UMDBPP/HELIOS/README.md

# HELIOS
Arduino code and CAD design files for the UMDBPP Helium Valve Payload
