UMDBPP/HELIOS/PCBShield/BOM.xlsx

Part | New Cost | Actual Cost | Quantity | Total | New Cost | Link | Resources
XBEE Module | $37.95 | $0.00 | 1 | $0.00 | $37.95 | https://www.adafruit.com/product/964
SD Card Breakout | $4.95 | $4.95 | 1 | $4.95 | $4.95 | https://www.digikey.com/product-detail/en/sparkfun-electronics/DEV-13743/1568-1356-ND/5881845
L293DNE | $2.95 | $0.00 | 1 | $0.00 | $2.95 | https://www.adafruit.com/product/807
I2C Multiplexer | $6.95 | $0.00 | 1 | $0.00 | $6.95 | https://www.adafruit.com/product/2717
GPS Breakout | $39.95 | $0.00 | 1 | $0.00 | $39.95 | https://www.adafruit.com/product/746
Logic Shifter | $3.50 | $3.50 | 1 | $3.50 | $3.50 | https://www.adafruit.com/product/1875
3.3V Regulator | $1.25 | $1.25 | 1 | $1.25 | $1.25 | https://www.adafruit.com/product/2165
Comparator | $3.39 | $3.39 | 1 | $3.39 | $3.39 | https://www.digikey.com/product-detail/en/linear-technology/LTC1042CN8-PBF/LTC1042CN8-PBF-ND/888973
50k Potentiometer | $2.08 | $2.08 | 1 | $2.08 | $2.08 | https://www.digikey.com/product-detail/en/bourns-inc/PV37W503C01B00/490-2984-ND/666611
10k Resistor | $0.10 | $0.00 | 2 | $0.00 | $0.20 | https://www.digikey.com/product-detail/en/stackpole-electronics-inc/CF14JT10K0/CF14JT10K0CT-ND/1830374
1k Resistor | $0.10 | $0.00 | 1 | $0.00 | $0.10 | https://www.digikey.com/product-detail/en/stackpole-electronics-inc/CF14JT1K00/CF14JT1K00CT-ND/1830350
4.7k Resistor | $0.10 | $0.00 | 16 | $0.00 | $1.60 | https://www.digikey.com/product-detail/en/stackpole-electronics-inc/CF14JT4K70/CF14JT4K70CT-ND/1830366
470 Resistor | $0.10 | $0.00 | 6 |  | $0.60 | https://www.digikey.com/product-detail/en/stackpole-electronics-inc/CF14JT470R/CF14JT470RCT-ND/1830342
N Channel MOSFET | $3.03 | $0.00 | 1 | $0.00 | $3.03 | https://www.digikey.com/products/en?keywords=FQP85N06 | https://media.digikey.com/pdf/Data%20Sheets/Fairchild%20PDFs/TO220B03_Pkg_Dwg.pdf
P Channel MOSFET | $1.33 | $0.00 | 2 | $0.00 | $2.66 | https://www.digikey.com/products/en?keywords=fqp27p06 | https://media.digikey.com/pdf/Data%20Sheets/Fairchild%20PDFs/TO220B03_Pkg_Dwg.pdf
High Power H Bridge | $5.06 | $5.06 | 1 | $5.06 | $5.06 | https://www.digikey.com/products/en?keywords=sla5074 | http://www.semicon.sanken-ele.co.jp/sk_content/sla5068_ds_en.pdf
2 Pin Headers | $0.49 | $0.49 | 5 | $2.45 | $2.45 | https://www.digikey.com/product-detail/en/sullins-connector-solutions/PPTC031LFBN-RC/S7001-ND/810142
3 Pin Headers | $0.64 | $0.64 | 2 | $1.28 | $1.28 | https://www.digikey.com/product-detail/en/sullins-connector-solutions/PPTC031LFBN-RC/S7001-ND/810143
4 Pin Headers | $0.46 | $0.46 | 10 | $4.63 | $4.63 | https://www.digikey.com/product-detail/en/sullins-connector-solutions/PPTC031LFBN-RC/S7001-ND/810144
6 Pin Headers | $0.78 | $0.78 | 6 | $4.68 | $4.68 | https://www.digikey.com/product-detail/en/sullins-connector-solutions/PPTC031LFBN-RC/S7001-ND/810145
7 Pin Headers | $0.86 | $0.86 | 1 | $0.86 | $0.86 | https://www.digikey.com/product-detail/en/sullins-connector-solutions/PPTC031LFBN-RC/S7001-ND/810146
9 Pin Headers | $0.94 | $0.94 | 1 | $0.94 | $0.94 | https://www.digikey.com/product-detail/en/sullins-connector-solutions/PPTC031LFBN-RC/S7001-ND/810148
12 Pin Headers | $0.98 | $0.98 | 2 | $1.96 | $1.96 | https://www.digikey.com/product-detail/en/sullins-connector-solutions/PPTC121LFBN-RC/S6100-ND/807231
8 Pin Shield Headers | $1.01 | $1.01 | 5 | $5.05 | $5.05 | https://www.digikey.com/product-detail/en/samtec-inc/SSW-108-03-T-S/SAM8866-ND/1790200
10 Pin Shield Headers | $1.61 | $1.61 | 1 | $1.61 | $1.61 | https://www.digikey.com/product-detail/en/samtec-inc/SSQ-110-03-F-S/SAM10010-ND/6678747
36 Pin Shield Headers | $4.19 | $4.19 | 1 | $4.19 | $4.19 | https://www.digikey.com/product-detail/en/samtec-inc/SSQ-118-03-T-D/SAM1204-18-ND/1111842
10 Pin Xbee Headers | $0.95 | $0.95 | 1 | $0.95 | $0.95 | https://www.adafruit.com/product/366
8DIP Socket | $0.19 | $0.19 | 1 | $0.19 | $0.19 | https://www.digikey.com/product-detail/en/on-shore-technology-inc/ED16DT/ED3046-5-ND/4147596
4DIP Socket | $0.16 | $0.16 | 1 | $0.16 | $0.16 | https://www.digikey.com/product-detail/en/on-shore-technology-inc/ED16DT/ED3046-5-ND/4147596
2 Pin Screw Terminals | $0.75 | $0.75 | 9 | $6.75 | $6.75 | https://www.digikey.com/product-detail/en/on-shore-technology-inc/OSTVN02A150/ED10561-ND/1588862 | https://www.sparkfun.com/products/10571
Printed Circuit Board | $20.47 | $20.47 | 3 | $61.41 | $61.40
 |  |  |  | $0.00 | $0.00
 |  |  |  | $0.00 | $0.00
 |  |  |  | $0.00 | $0.00
 |  |  |  | $0.00 | $0.00
 | Total | $117.34 | $213.32
Header Requirements
LEDs | ~~4pin~~ | 2
Actuators | ~~2pin~~ | 5
Actuators | ~~3pin~~ | 2
Multiplexer | ~~12pin~~ | 2
I2C | ~~4pin~~ | 8
Comparator | ~~4DIP~~ | 1
SD Card | ~~7pin~~ | 1
GPS | ~~9pin~~ | 1
H Bridge | ~~8DIP~~ | 1
SPI | ~~6pin~~ | 4
Xbee | ~~10pinx0.5"~~ | 2
Logic Shifter | ~~6pin~~ | 2
Power | ~~2screw~~ | 9
Arduino | ~~10pin_through~~ | 1
Arduino | ~~8pin_through~~ | 5
Arduino | ~~18x2pin_through~~ | 1
Xbee to USB Adapter | 29.95 |  | 1 |  |  | https://www.adafruit.com/product/247 | This is definitely not necessay for this board, but would it be useful for testing in the future?
