UMDBPP/HELIOS/CAD/ActuatorCapPrecise.stl

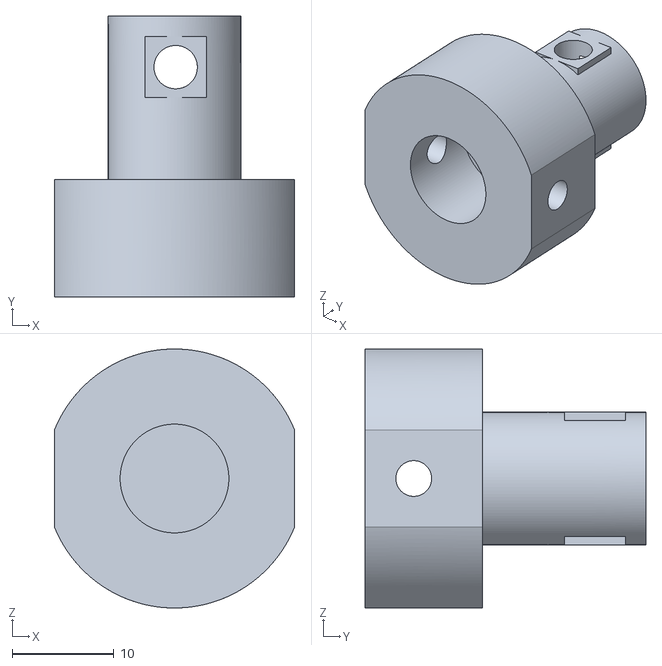
[picture p1: CAD file, 2017-04-02]
CAD/ActuatorCapPrecise.stl
23.5 x 27.5 x 25.4
