UMDBPP/HELIOS/CAD/ActuatorCap.stl

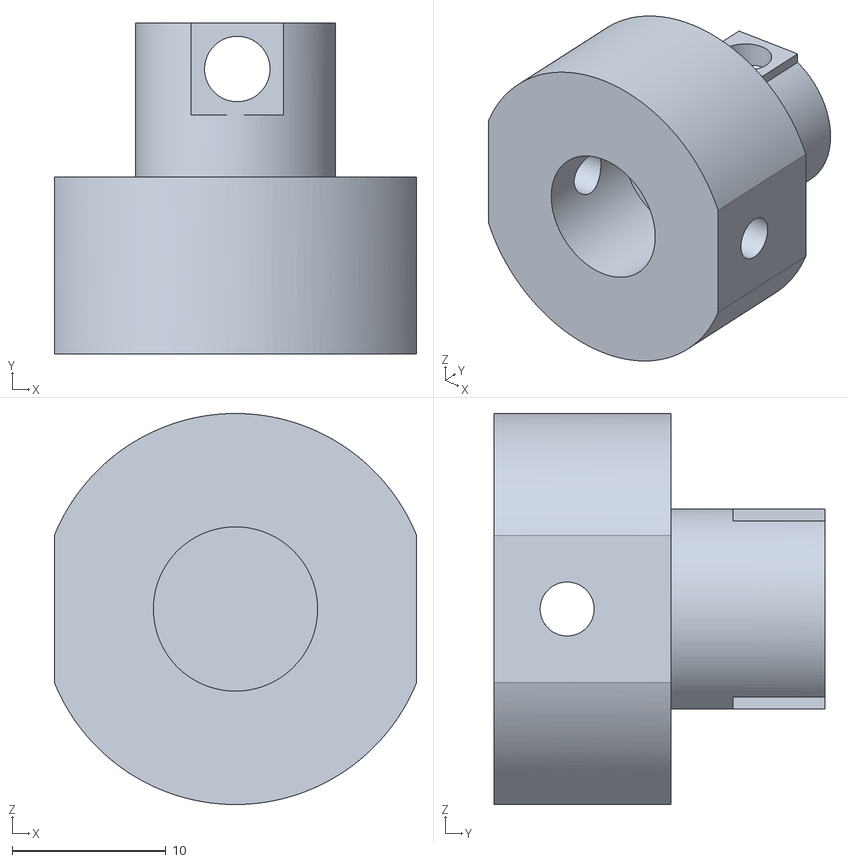
[picture p2: CAD file, 2017-03-31]
CAD/ActuatorCap.stl
23.5 x 21.5 x 25.4
