UMDBPP/HELIOS/CAD/ExtendedHousingLASide1.stl

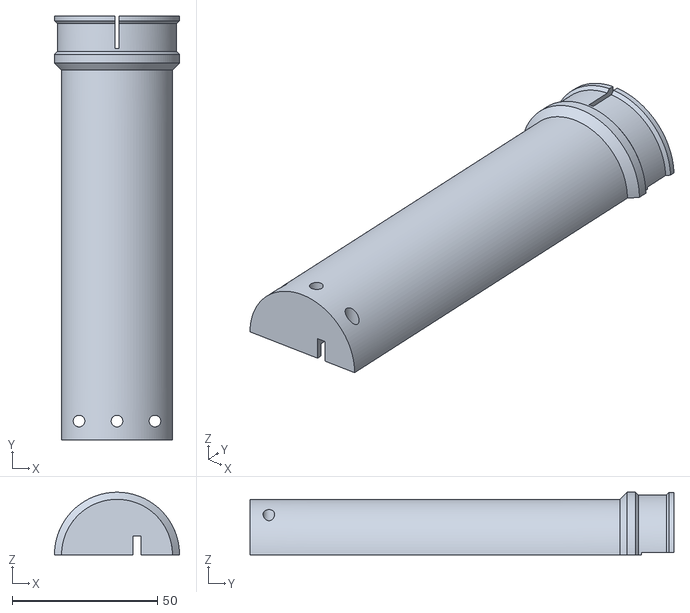
[picture p3: CAD file, 2017-03-28]
CAD/ExtendedHousingLASide1.stl
43.0 x 145.7 x 21.5
