UMDBPP/HELIOS/(list of files, cad)

Other CAD files:
CAD/ExtendedHousingLASide2.stl
CAD/Plug.dwg
CAD/ValveStem.dwg
CAD/Disc.dwg
CAD/ActuatorCap.ipt
CAD/ActuatorCapPrecise.ipt
CAD/ActuatorExtended.ipt
CAD/ActuatorRetracted.ipt
CAD/Disc.ipt
CAD/ExtendedHousingLAMaster.ipt
CAD/ExtendedHousingLASide1.ipt
CAD/ExtendedHousingLASide2.ipt
CAD/EyeBolt.ipt
CAD/Fan.ipt
CAD/FanMount.ipt
CAD/FillPlug.ipt
CAD/FillPort.ipt
CAD/FillPortUpdated.ipt
CAD/Helios.iam
CAD/LargeO-Ring.ipt
CAD/Plug.ipt
CAD/Prototypes/ExtendedHousingSide1wWireSupport.ipt
CAD/Prototypes/ExtendedHousingSide1wWireSupportPrototype.ipt
CAD/Prototypes/ExtendedHousingSide2wWireSupport.ipt
CAD/Prototypes/ExtendedHousingSide2wWireSupportPrototype.ipt
CAD/Prototypes/FullExtendedHousingSide1.ipt
CAD/Prototypes/FullExtendedHousingSide2.ipt
CAD/ReciprocatingO-Ring.ipt
CAD/ValveStem.ipt
