UMDBPP/HELIOS/WiringDiagram/Helios_v3_wire_diagram.png

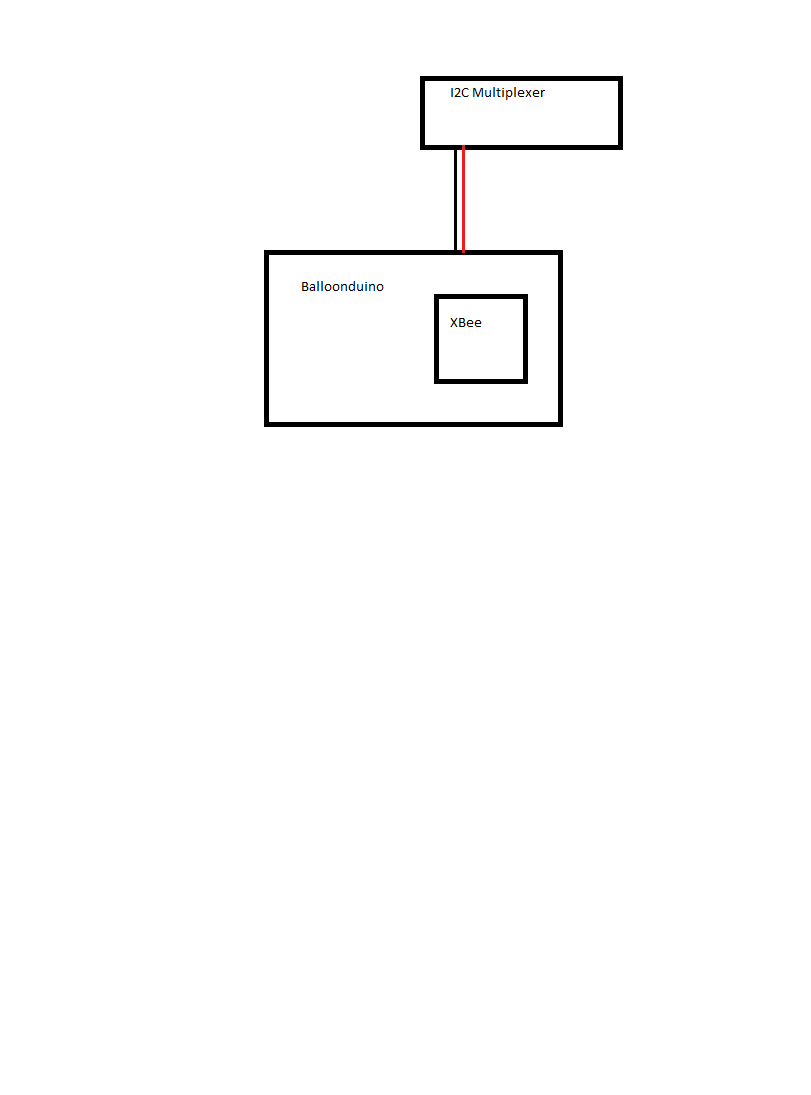
WiringDiagram/Helios_v3_wire_diagram.png
