UMDBPP/HELIOS/CAD/Disc.pdf

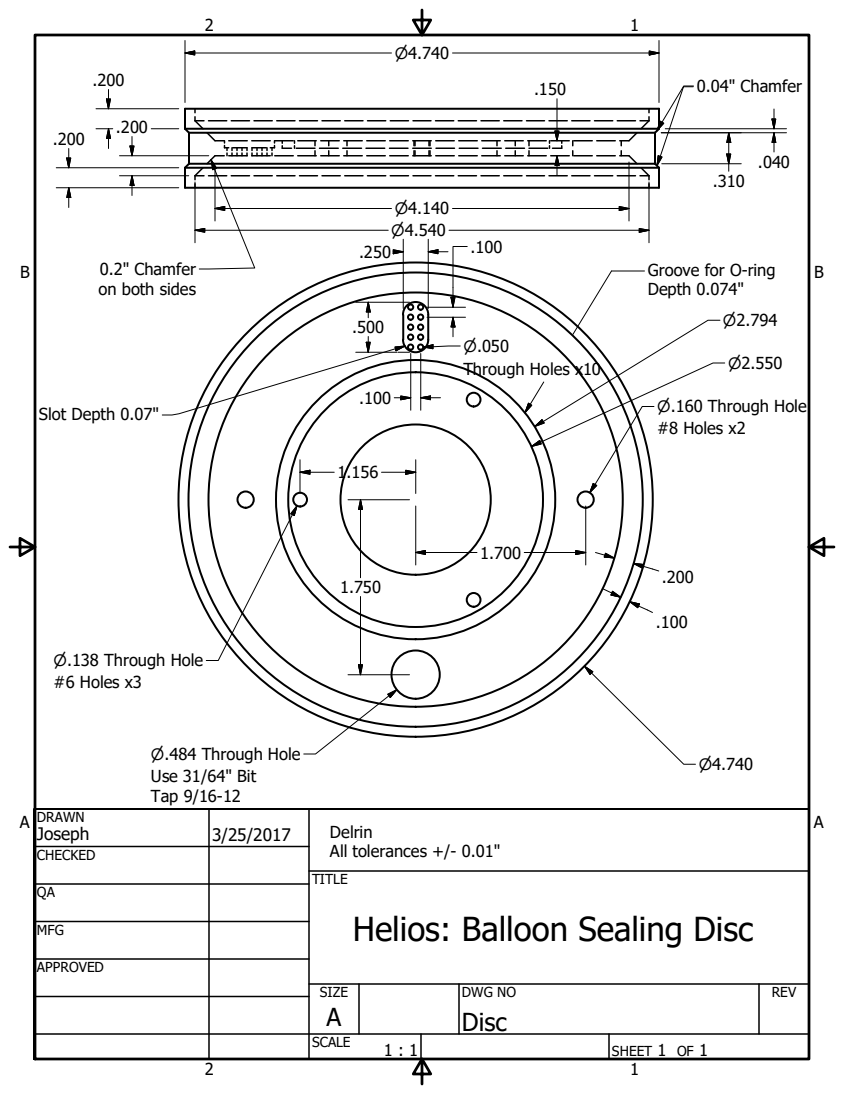
[picture p5: page 1]
SHEET 1 OF 1; DRAWN; CHECKED; MFG; APPROVED; Joseph; DWG NO Disc; SIZE A; SCALE; REV; Delrin All tolerances +/- 0.01"; P.160 Through Hole; #8 Holes x2; P.138 Through Hole; #6 Holes x3; Through Holes x10; P.484 Through Hole; Use 31/64" Bit Tap 9/16-12; 0.04" Chamfer; Slot Depth 0.07"

0.2" Chamfer
on both sides

Groove for O-ring
Depth 0.074"

TITLE
Helios: Balloon Sealing Disc
