UMDBPP/HELIOS/CAD/Plug.pdf

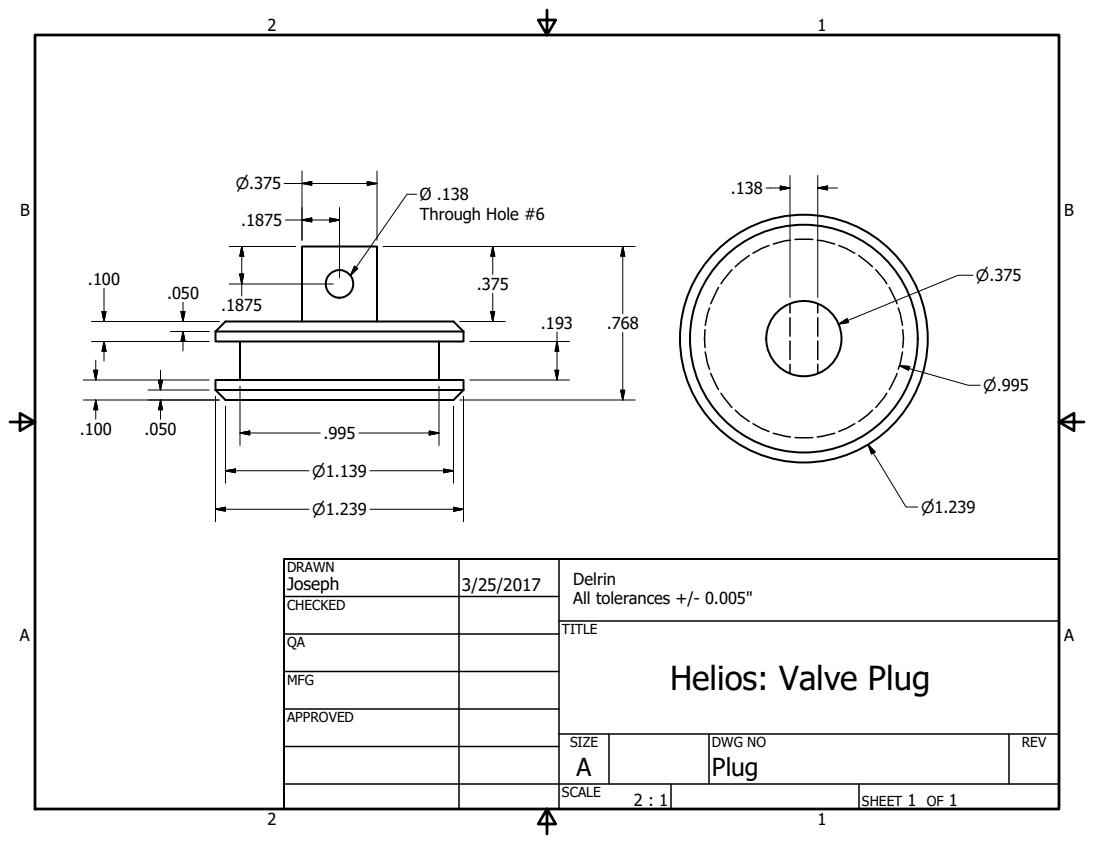
[picture p6: page 1]
SHEET 1 OF 1; DRAWN; CHECKED; MFG; APPROVED; Joseph; DWG NO Plug; TITLE; SIZE A; SCALE; REV; Delrin All tolerances +/- 0.005"; Ø .138 Through Hole #6

Helios: Valve Plug
