UMDBPP/HELIOS/CAD/ValveStem.pdf

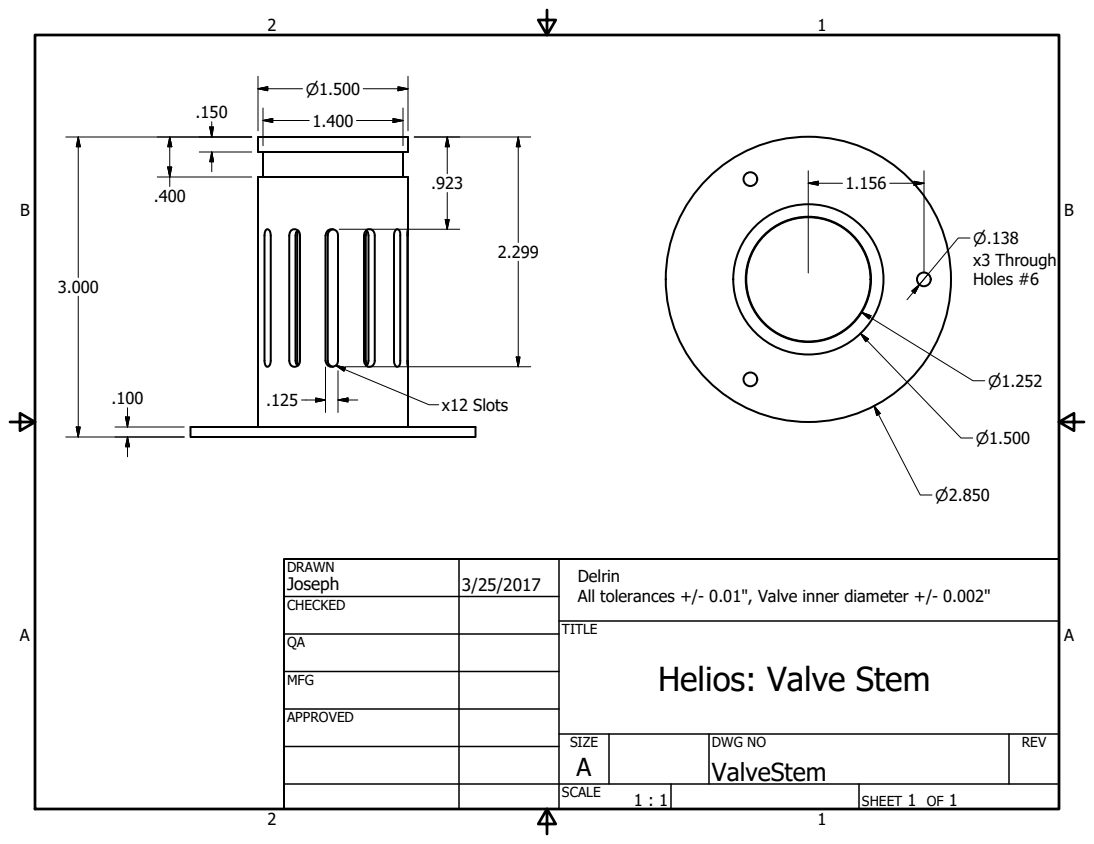
[picture p7: page 1]
SHEET 1 OF 1; DRAWN; CHECKED; MFG; APPROVED; Joseph; DWG NO ValveStem; TITLE; SIZE A; SCALE; REV; x3 Through Holes #6; x12 Slots

Delrin
All tolerances +/- 0.01", Valve inner diameter +/- 0.002"

Helios: Valve Stem
