UMDBPP/HELIOS/PCBShield/shield.brd

## EAGLE design PCBShield/shield.brd (2017-09-26)

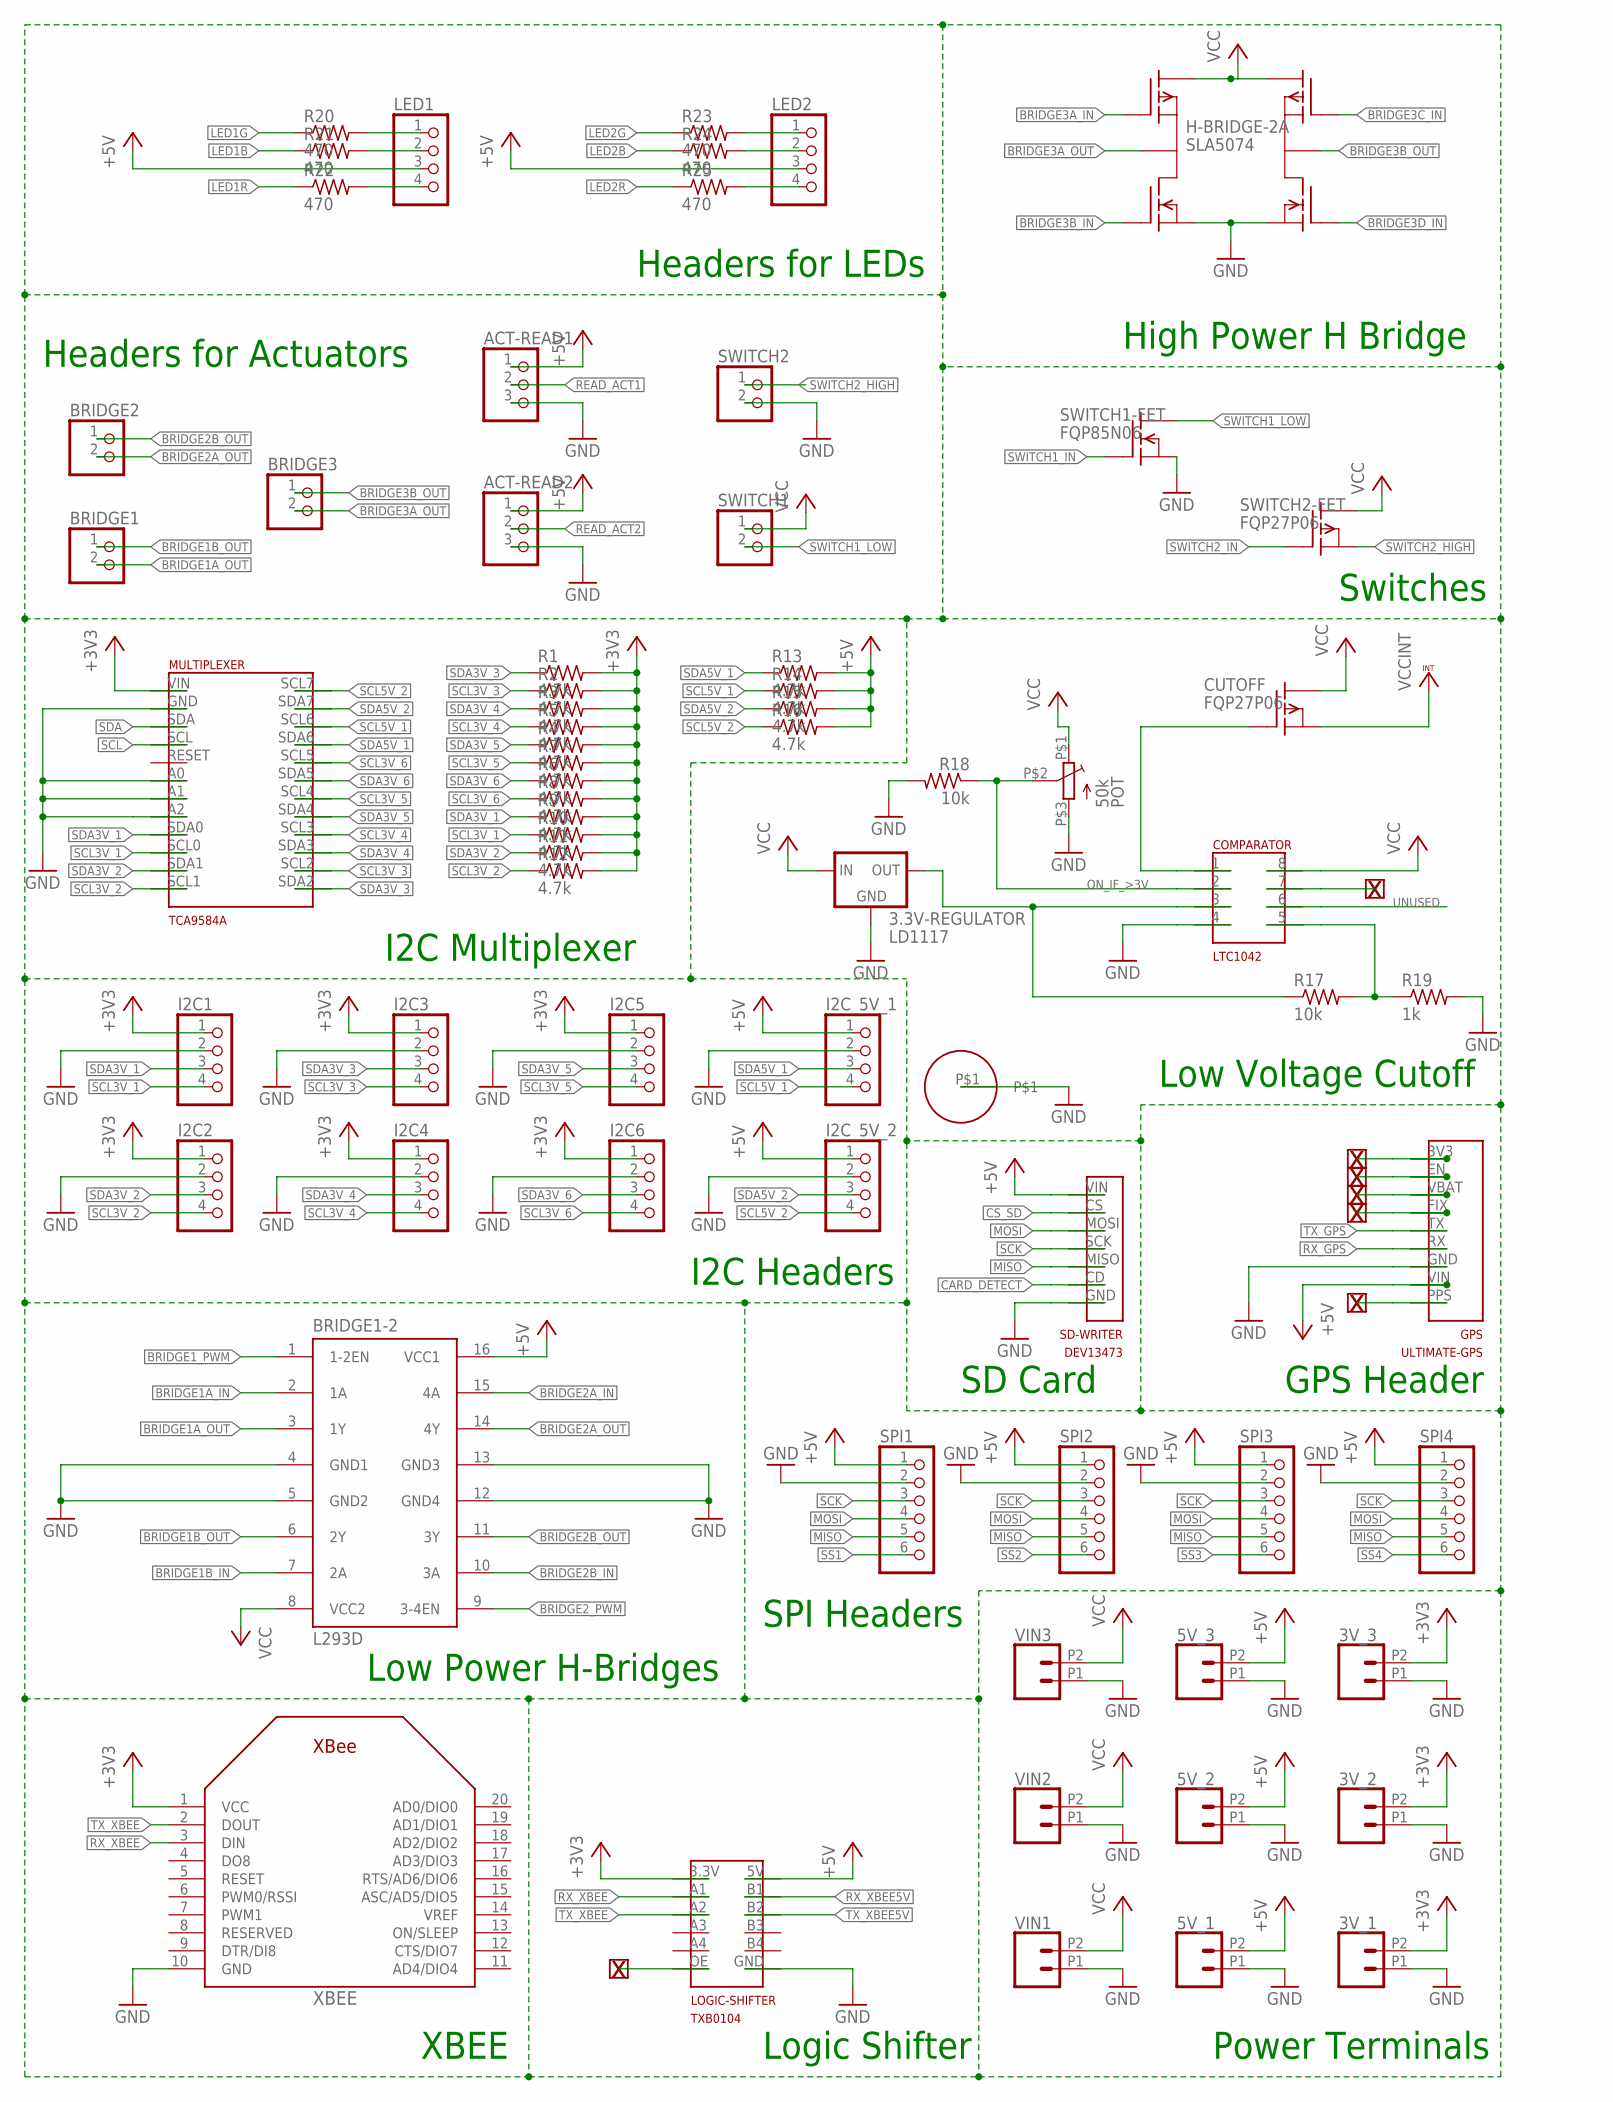
[picture p8: schematic shield.sch, sheet 1]

Parts:
3.3V-REGULATOR: LD1117; REGULATOR
3V_1, 3V_2, 3V_3, 5V_1, 5V_2, 5V_3: CONN_022.54MM_SCREWTERM; 1X02_2.54_SCREWTERM
ACT-READ1, ACT-READ2: PINHD-1X3; 1X03
BRIDGE1, BRIDGE2, BRIDGE3: PINHD-1X2; 1X02
BRIDGE1-2: L293D; DIL16
COMPARATOR: LTC1042; DIP8
CUTOFF: FQP27P06; MOSFET
GPS: ULTIMATE-GPS; GPS
H-BRIDGE-2A: SLA5074; SANKEN
I2C1, I2C2, I2C3, I2C4, I2C5, I2C6, I2C_5V_1, I2C_5V_2: PINHD-1X4; 1X04
LED1, LED2: PINHD-1X4; 1X04
LOGIC-SHIFTER: TXB0104
MULTIPLEXER: TCA9584A
POT: 50k; PV37W503C01B00
R1, R2, R3, R4, R5, R6, R7, R8, R9, R10, R11, R12, R13, R14, R15, R16: 4.7k; 0805-THM
R17, R18: 10k; 0805-THM
R19: 1k; 0805-THM
R20, R21, R22, R23, R24, R25: 470; 0805-THM
SD-WRITER: DEV13473; DEV13743
SPI1, SPI2, SPI3, SPI4: PINHD-1X6; 1X06
SWITCH1, SWITCH2: PINHD-1X2; 1X02
SWITCH1-FET: FQP85N06; MOSFET
SWITCH2-FET: FQP27P06; MOSFET
U$1: 6BOLT
VIN1, VIN2, VIN3: CONN_022.54MM_SCREWTERM; 1X02_2.54_SCREWTERM
XBEE: XBEE

Connections:
0.3V: COMPARATOR.5 (WIDTH/2), R17.2, R19.1
+3V3: 3V_1.P2 (2), 3V_2.P2 (2), 3V_3.P2 (2), I2C1.1, I2C2.1, I2C3.1, I2C4.1, I2C5.1, I2C6.1, LOGIC-SHIFTER.3.3V (3V3), MULTIPLEXER.VIN, R1.2, R2.2, R3.2, R4.2, R5.2, R6.2, R7.2, R8.2, R9.2, R10.2, R11.2, R12.2, XBEE.1 (VCC); also elsewhere on the board
+5V: 5V_1.P2 (2), 5V_2.P2 (2), 5V_3.P2 (2), ACT-READ1.1, ACT-READ2.1, BRIDGE1-2.16 (VCC1), GPS.VIN, I2C_5V_1.1, I2C_5V_2.1, LED1.3, LED2.3, LOGIC-SHIFTER.5V, R13.2, R14.2, R15.2, R16.2, SD-WRITER.VIN, SPI1.1, SPI2.1, SPI3.1, SPI4.1; also elsewhere on the board
BRIDGE1A_IN: BRIDGE1-2.2 (1A); also elsewhere on the board
BRIDGE1A_OUT: BRIDGE1.2, BRIDGE1-2.3 (1Y)
BRIDGE1B_IN: BRIDGE1-2.7 (2A); also elsewhere on the board
BRIDGE1B_OUT: BRIDGE1.1, BRIDGE1-2.6 (2Y)
BRIDGE1_PWM: BRIDGE1-2.1 (1-2EN); also elsewhere on the board
BRIDGE2A_IN: BRIDGE1-2.15 (4A); also elsewhere on the board
BRIDGE2A_OUT: BRIDGE1-2.14 (4Y), BRIDGE2.2
BRIDGE2B_IN: BRIDGE1-2.10 (3A); also elsewhere on the board
BRIDGE2B_OUT: BRIDGE1-2.11 (3Y), BRIDGE2.1
BRIDGE2_PWM: BRIDGE1-2.9 (3-4EN); also elsewhere on the board
BRIDGE3A_IN: H-BRIDGE-2A.P$4; also elsewhere on the board
BRIDGE3A_OUT: BRIDGE3.2, H-BRIDGE-2A.P$3
BRIDGE3B_IN: H-BRIDGE-2A.P$2; also elsewhere on the board
BRIDGE3B_OUT: BRIDGE3.1, H-BRIDGE-2A.P$7
BRIDGE3C_IN: H-BRIDGE-2A.P$9; also elsewhere on the board
BRIDGE3D_IN: H-BRIDGE-2A.P$6; also elsewhere on the board
CARD_DETECT: SD-WRITER.CD
CS_SD: SD-WRITER.CS; also elsewhere on the board
GND: 3.3V-REGULATOR.GND, 3V_1.P1 (1), 3V_2.P1 (1), 3V_3.P1 (1), 5V_1.P1 (1), 5V_2.P1 (1), 5V_3.P1 (1), ACT-READ1.3, ACT-READ2.3, BRIDGE1-2.4 (GND1), BRIDGE1-2.5 (GND2), BRIDGE1-2.12 (GND4), BRIDGE1-2.13 (GND3), COMPARATOR.4 (GND), GPS.GND, H-BRIDGE-2A.P$1, H-BRIDGE-2A.P$8, I2C1.2, I2C2.2, I2C3.2, I2C4.2, I2C5.2, I2C6.2, I2C_5V_1.2, I2C_5V_2.2, LOGIC-SHIFTER.GND, MULTIPLEXER.A0, MULTIPLEXER.A1, MULTIPLEXER.A2, MULTIPLEXER.GND, POT.P$3, R18.2, R19.2, SD-WRITER.GND, SPI1.2, SPI2.2, SPI3.2, SPI4.2, SWITCH1-FET.S, SWITCH2.2, U$1.P$1, VIN1.P1 (1), VIN2.P1 (1), VIN3.P1 (1), XBEE.10 (GND); also elsewhere on the board
LED1B: R21.1; also elsewhere on the board
LED1G: R20.1; also elsewhere on the board
LED1R: R22.1; also elsewhere on the board
LED2B: R24.1; also elsewhere on the board
LED2G: R23.1; also elsewhere on the board
LED2R: R25.1; also elsewhere on the board
MISO: SD-WRITER.MISO, SPI1.5, SPI2.5, SPI3.5, SPI4.5; also elsewhere on the board
MOSI: SD-WRITER.MOSI, SPI1.4, SPI2.4, SPI3.4, SPI4.4; also elsewhere on the board
unnamed: LED1.1, R20.2
unnamed: LED1.2, R21.2
unnamed: LED1.4, R22.2
unnamed: LED2.1, R23.2
unnamed: LED2.2, R24.2
unnamed: LED2.4, R25.2
ON_IF_>3V: COMPARATOR.2 (CENTER), POT.P$2, R18.1
POWER-ON: COMPARATOR.1 (WITHIN-WINDOW), CUTOFF.G
READ_ACT1: ACT-READ1.2; also elsewhere on the board
READ_ACT2: ACT-READ2.2; also elsewhere on the board
REG-3V3: 3.3V-REGULATOR.VOUT, COMPARATOR.3 (VIN), R17.1
RX_GPS: GPS.RX; also elsewhere on the board
RX_XBEE: LOGIC-SHIFTER.A1, XBEE.3 (DIN)
RX_XBEE5V: LOGIC-SHIFTER.B1; also elsewhere on the board
SCK: SD-WRITER.SCK, SPI1.3, SPI2.3, SPI3.3, SPI4.3; also elsewhere on the board
SCL: MULTIPLEXER.SCL; also elsewhere on the board
SCL3V_1: I2C1.4, MULTIPLEXER.SCL0, R10.1
SCL3V_2: I2C2.4, MULTIPLEXER.SCL1, R12.1
SCL3V_3: I2C3.4, MULTIPLEXER.SCL2, R2.1
SCL3V_4: I2C4.4, MULTIPLEXER.SCL3, R5.1
SCL3V_5: I2C5.4, MULTIPLEXER.SCL4, R7.1
SCL3V_6: I2C6.4, MULTIPLEXER.SCL5, R8.1
SCL5V_1: I2C_5V_1.4, MULTIPLEXER.SCL6, R14.1
SCL5V_2: I2C_5V_2.4, MULTIPLEXER.SCL7, R16.1
SDA: MULTIPLEXER.SDA; also elsewhere on the board
SDA3V_1: I2C1.3, MULTIPLEXER.SDA0, R9.1
SDA3V_2: I2C2.3, MULTIPLEXER.SDA1, R11.1
SDA3V_3: I2C3.3, MULTIPLEXER.SDA2, R1.1
SDA3V_4: I2C4.3, MULTIPLEXER.SDA3, R3.1
SDA3V_5: I2C5.3, MULTIPLEXER.SDA4, R4.1
SDA3V_6: I2C6.3, MULTIPLEXER.SDA5, R6.1
SDA5V_1: I2C_5V_1.3, MULTIPLEXER.SDA6, R13.1
SDA5V_2: I2C_5V_2.3, MULTIPLEXER.SDA7, R15.1
SS1: SPI1.6; also elsewhere on the board
SS2: SPI2.6; also elsewhere on the board
SS3: SPI3.6; also elsewhere on the board
SS4: SPI4.6; also elsewhere on the board
SWITCH1_IN: SWITCH1-FET.G; also elsewhere on the board
SWITCH1_LOW: SWITCH1.2, SWITCH1-FET.D
SWITCH2_HIGH: SWITCH2.1, SWITCH2-FET.S
SWITCH2_IN: SWITCH2-FET.G; also elsewhere on the board
TX_GPS: GPS.TX; also elsewhere on the board
TX_XBEE: LOGIC-SHIFTER.A2, XBEE.2 (DOUT)
TX_XBEE5V: LOGIC-SHIFTER.B2; also elsewhere on the board
UNUSED: COMPARATOR.6 (ABOVE-WINDOW)
VCC: 3.3V-REGULATOR.VIN, BRIDGE1-2.8 (VCC2), COMPARATOR.8 (V+), CUTOFF.D, H-BRIDGE-2A.P$5, H-BRIDGE-2A.P$10, POT.P$1, SWITCH1.1, SWITCH2-FET.D, VIN1.P2 (2), VIN2.P2 (2), VIN3.P2 (2)
VCCINT: CUTOFF.S; also elsewhere on the board

Notes on the sheet:
I2C Multiplexer
XBEE
Low Power H-Bridges
I2C Headers
Power Terminals
SPI Headers
SD Card
GPS Header
Logic Shifter
Low Voltage Cutoff
Headers for Actuators
High Power H Bridge
Switches
Headers for LEDs

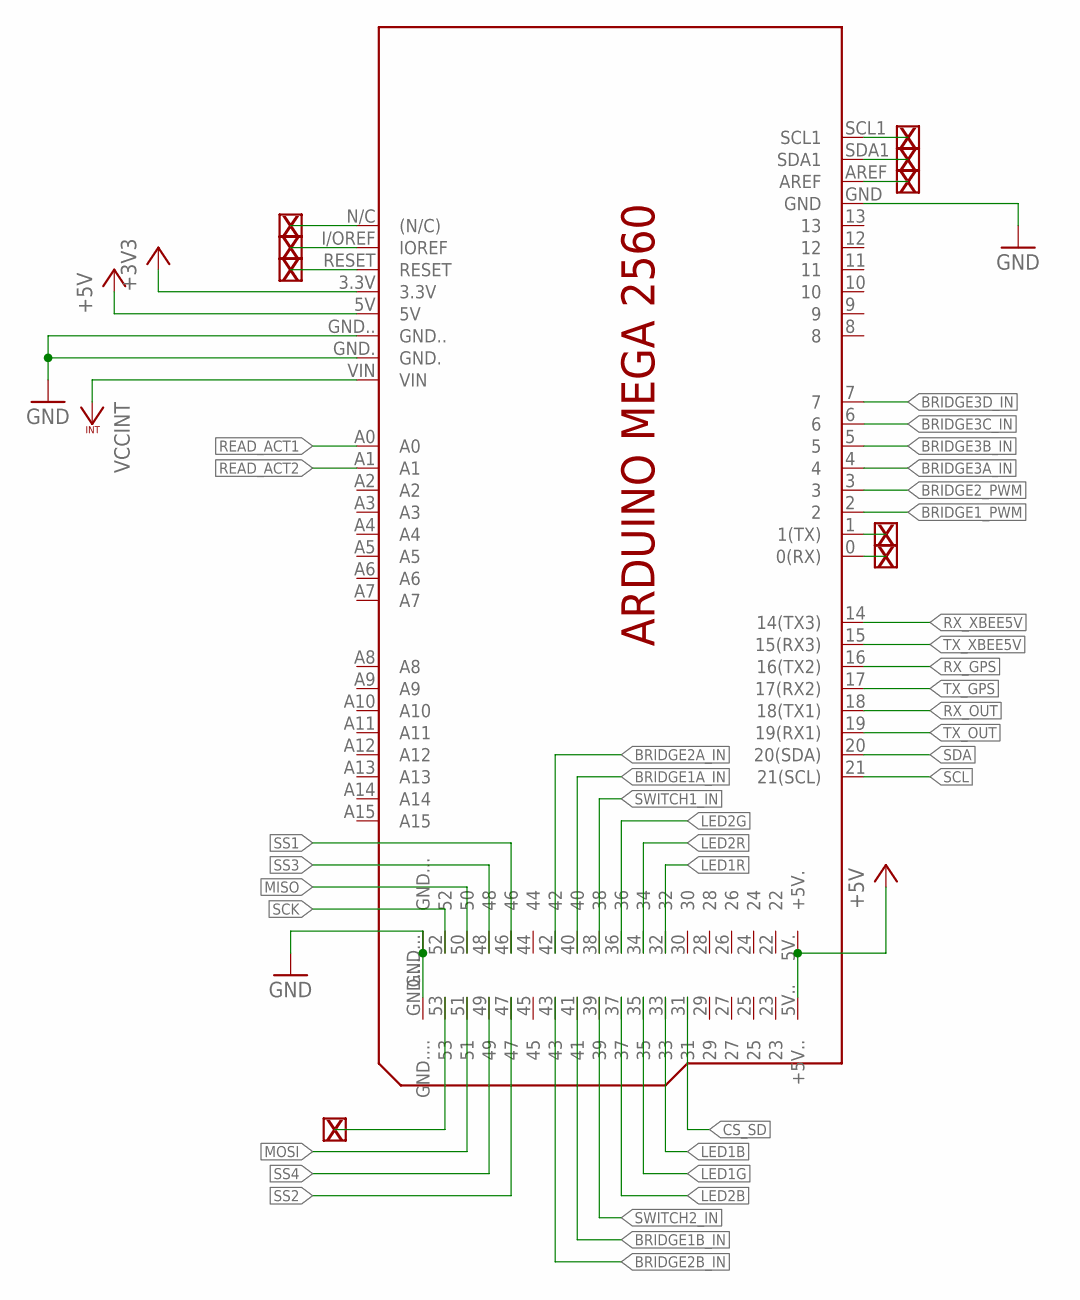
[picture p9: schematic shield.sch, sheet 2]

Parts:
PCB2: ARDUINO_MEGA2560_SHIELD

Connections:
+3V3: PCB2.3.3V; also elsewhere on the board
+5V: PCB2.5V, PCB2.5V. (+5V.), PCB2.5V.. (+5V..); also elsewhere on the board
BRIDGE1A_IN: PCB2.40; also elsewhere on the board
BRIDGE1B_IN: PCB2.41; also elsewhere on the board
BRIDGE1_PWM: PCB2.2; also elsewhere on the board
BRIDGE2A_IN: PCB2.42; also elsewhere on the board
BRIDGE2B_IN: PCB2.43; also elsewhere on the board
BRIDGE2_PWM: PCB2.3; also elsewhere on the board
BRIDGE3A_IN: PCB2.4; also elsewhere on the board
BRIDGE3B_IN: PCB2.5; also elsewhere on the board
BRIDGE3C_IN: PCB2.6; also elsewhere on the board
BRIDGE3D_IN: PCB2.7; also elsewhere on the board
CS_SD: PCB2.31; also elsewhere on the board
GND: PCB2.GND, PCB2.GND., PCB2.GND.., PCB2.GND..., PCB2.GND....; also elsewhere on the board
LED1B: PCB2.33; also elsewhere on the board
LED1G: PCB2.35; also elsewhere on the board
LED1R: PCB2.32; also elsewhere on the board
LED2B: PCB2.37; also elsewhere on the board
LED2G: PCB2.36; also elsewhere on the board
LED2R: PCB2.34; also elsewhere on the board
MISO: PCB2.50; also elsewhere on the board
MOSI: PCB2.51; also elsewhere on the board
READ_ACT1: PCB2.A0; also elsewhere on the board
READ_ACT2: PCB2.A1; also elsewhere on the board
RESERVED: PCB2.1 (1(TX))
RX_GPS: PCB2.16 (16(TX2)); also elsewhere on the board
RX_OUT: PCB2.18 (18(TX1))
RX_XBEE5V: PCB2.14 (14(TX3)); also elsewhere on the board
SCK: PCB2.52; also elsewhere on the board
SCL: PCB2.21 (21(SCL)); also elsewhere on the board
SDA: PCB2.20 (20(SDA)); also elsewhere on the board
SS1: PCB2.46; also elsewhere on the board
SS2: PCB2.47; also elsewhere on the board
SS3: PCB2.48; also elsewhere on the board
SS4: PCB2.49; also elsewhere on the board
SS_MASTER: PCB2.53
SWITCH1_IN: PCB2.38; also elsewhere on the board
SWITCH2_IN: PCB2.39; also elsewhere on the board
TX_GPS: PCB2.17 (17(RX2)); also elsewhere on the board
TX_OUT: PCB2.19 (19(RX1))
TX_XBEE5V: PCB2.15 (15(RX3)); also elsewhere on the board
VCCINT: PCB2.VIN; also elsewhere on the board

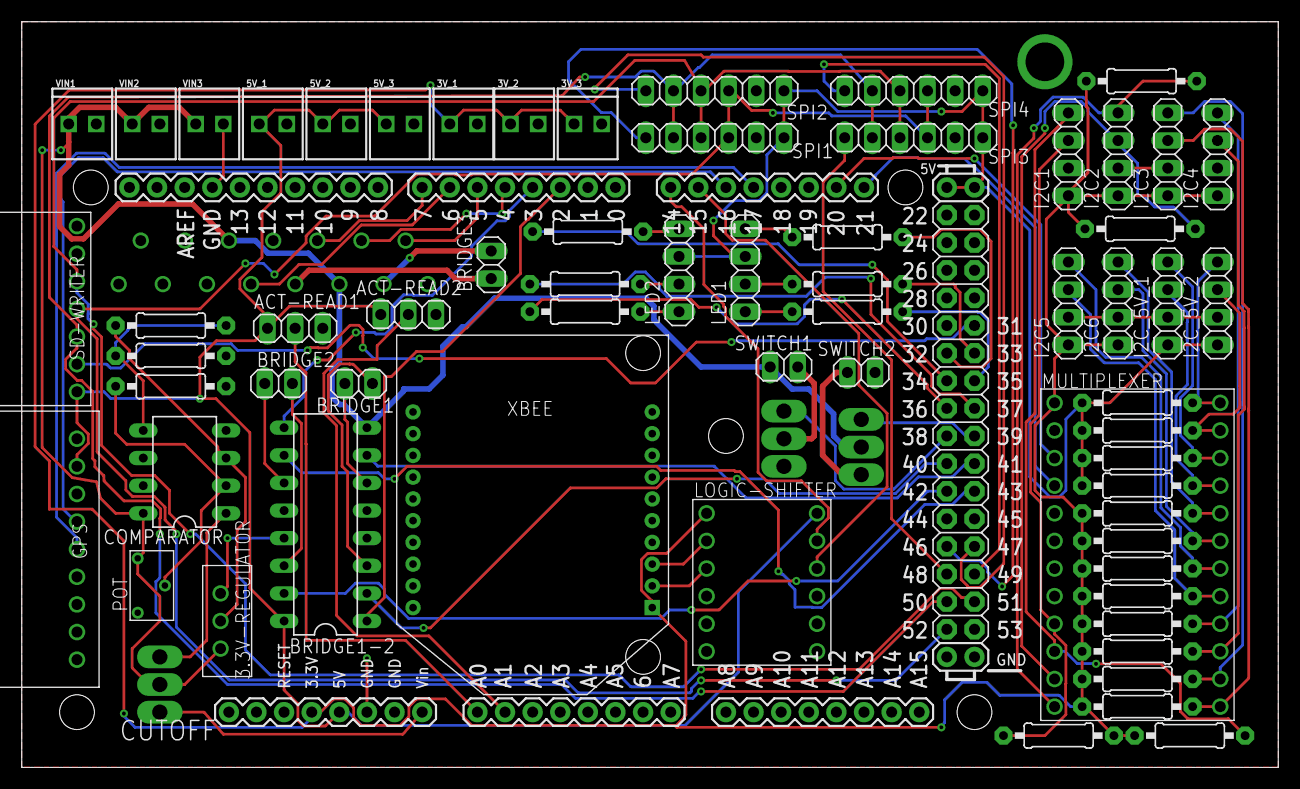
[picture p10: board shield.brd from above]

Board: 2 copper layers, 115.6 x 68.6 mm, 70 parts (0 on the bottom side), 75 nets.
