UMDBPP/HELIOS/Helios_Reorganized/src/hardware/myNichrome.cpp

#include "../../include/hardware/myNichrome.h"

void myNichrome::initialize(){
  pinMode(PIN, OUTPUT);
  digitalWrite(PIN, LOW);
  if (HELIOS_DEBUG) Serial.println("Nichrome pins have been initialized");
}

void myNichrome::startHeat(){
  digitalWrite(PIN, HIGH);
  if (HELIOS_DEBUG && state != HIGH) Serial.println("Nichrome has been turned on.");
  state = HIGH;
}

void myNichrome::endHeat(){
  digitalWrite(PIN, LOW);
  if (HELIOS_DEBUG && state != LOW) Serial.println("Nichrome has been turned off.");
  state = LOW;
}
