UMDBPP/HELIOS/(commit log)

2017-03-26 Added xbee code for trinket and ground station
2017-03-26 Adding initial CAD files
    [ActuatorCap.ipt, ActuatorExtended.ipt, ActuatorRetracted.ipt, Disc.dwg, Disc.ipt, EyeBolt.ipt, Fan.ipt, FanMount.ipt]
2017-03-28 Added 3D printed valve housing
    [ExtendedHousingLAMaster.ipt, ExtendedHousingLASide1.ipt, ExtendedHousingLASide2.ipt, Helios.iam]
2017-03-28 Added high resolution .stl for printed parts.
    [ActuatorCap.stl, ExtendedHousingLASide1.stl, ExtendedHousingLASide2.stl]
2017-03-30 Xbees work, Trinket I2C sort of works
2017-03-31 Working flight code and circuit board except trinket
    [ActuatorCap.ipt, ActuatorCap.stl, Helios.iam]
2017-03-31 Everything but the GPS running, BMEs still missing, Trinket working great
    [Helios.ino, Xbee.ino]
2017-04-02 Added CAD file for modified actuator cap, correct length and tighter fit
    [ActuatorCapPrecise.ipt, ActuatorCapPrecise.stl]
2017-06-21 Basic Wiring Diagram
    Adding a high level block diagram of the electroncs hardware
2017-06-24 Revised cmd_tlm to reflect new valve timing and interface
2017-06-24 xbee test successful. Command values and code modified to prevent overflow errors
    [XbeeFunctions.cpp]
2017-06-26 Updated pin numbers for this flight. Actuator and fan not yet tested
2017-06-27 LED now works. Colors have not been verified
2017-07-01 Changed pin numbers for flight
2017-07-03 Full flight code for NS66. Pressure sensors and actautor sensor removed due to hardware issues
    [ActuatorFunctions.cpp, GPSFunctions.cpp, Helios.ino, HoneywellFunctions.cpp, LEDFunctions.cpp, LogFunctions.cpp, MotorFunctions.cpp, XbeeFunctions.cpp]
2017-07-14 Revised code back to read actuator position for new working actuator
2017-07-14 Pressure sensor test code'
    :
    '
2017-07-15 Working Pressure Sensor CPP
2017-09-08 First complete version of a pcb shield schematic added
    [BOM.xlsx, shield.sch]
2017-09-08 Modified xbee class and ground system parameters to reflect more advanced usage of xbees. Untested because I'm having trouble with the compiler again.
2017-09-15 Now all custom parts have been created for the printed circuit board so actual board design can begin smoothly
    [BOM.xlsx, shield.sch]
2017-09-15 Revised board design to include only pins needed for a shield (no ISP header or USB/POWER). Added hole for reset switch
    [shield.sch]
2017-09-15 Preliminary arrangement of components on board complete, and several connections on schematic have been fixed.
    [shield.brd, shield.sch]
2017-09-16 Board is laid out and ready for routing. Screw terminals replace
    [shield.brd, shield.sch]
2017-09-16 First version of board complete including routing, pending verification
    [shield.brd, shield.sch]
2017-09-21 Code fully compiles with GPS too. Modified interface to fully utilize h files which seems to have the code much more cooperative. Also recoded LED to no longer use NeoPixels interface
    [Helios.ino, myGPS.cpp, myGPS.h]
2017-09-21 Made a few more changes for neatness. Code now compiles and follows a consistent format. Main practical changes were in the LED and Xbee files. All other changes are just reorganization for better ad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
2017-09-22 Modified board to fit Xbee Pro size module and completed full BOM
    [BOM.xlsx, shield.brd, shield.sch]
2017-09-22 Fully commented code. Also defined the myPins.h file which contains all the definitions for which pins are which on the PCB
2017-09-25 Final version of PCB for printing
    [BOM.xlsx, shield.brd, shield.sch]
2017-09-26 @blaire ORDER THIS ONE
    [shield.brd]
2017-10-16 Updated with final part quantities and costs
    [BOM.xlsx]
2017-10-18 bug fixes and test code added
    [Helios.ino]
2017-10-19 Tested and fixed BME code, finalized code for thermal test
    [Helios.ino, myBME.cpp, myBME.h, myPins.h, mySSC.cpp, mySSC.h]
2018-02-23 Updated code for spring flight, modified LED mechanics, and the helios_debug include location. Still need to update to work with new xbee libary
2018-03-31 Fixed valve opening logic, modified LED statuses; Helios NS-75 final flight code
    [Helios.ino]
2019-03-30 Updated sensor failure message
    [mySSC.cpp]
2019-04-02 Changed the .gitignore to not show autosave versions of the PCB
2019-04-02 Added prototypes folder and a readme
2019-04-09 New Actuator w Wire SUpport
    [ExtendedHousingSide1wWireSupportPrototype.ipt, ExtendedHousingSide2wWireSupportPrototype.ipt]
2019-04-15 Update myBITS.cpp
    Updates to myBits code functions, checkForMessage and processMessage. I commented out the print statements in both. processMessage part still needs if statements for stuff from header file.
2019-04-16 No changes. Autodesk is dumb.
    [ExtendedHousingSide1wWireSupportPrototype.ipt, ExtendedHousingSide2wWireSupportPrototype.ipt]
2019-04-16 Added housing files as printed for NS-82
    [FullExtendedHousingSide1.ipt, FullExtendedHousingSide2.ipt]
2019-04-16 Removed references to the myXbee class, replaced with the myBITS class, and ensured code compiles. Still need to fix all the options within the xbeeCommand() function
    [flight.cpp, myBITS.cpp, myBITS.h, processes.cpp, thermalTest.cpp]
2019-04-17 Commented out references to the pressure sensors that won't be used on NS-82.
    [benchtest.cpp, flight.cpp, functions.cpp, myBITS.cpp, myBITS.h, myLog.cpp, myPins.h, myXbee.cpp]
2019-04-17 Added nichrome control capability, and added a second valveState object to control it. Still need to add timer.
2019-04-17 Added files for polling external switches and keeping track of toggle times
2019-04-17 Corrected logic flow
2019-04-18 Added the capability to read a toggle switch and coordinate a timer based off of it
2019-04-18 Added a line to let the valve work on a timer too. Use the flight code with this extra line and the duration changed for the thermal test--then delete this line immediately
2019-04-19 Added CAD Files with mounting plane
    [ExtendedHousingSide1wWireSupport.ipt, ExtendedHousingSide2wWireSupport.ipt]
2019-04-19 Changed the way the xbee logs to datalog to inline rather than insertion
2019-04-19 Added send to ground messages when valve/cutdown activate
2019-04-19 Added code so that turning the switch causes an xbee command to send
